gi6rgi/autonomous-drone-v2/hardware/frame_v3/print/box_deck.stl

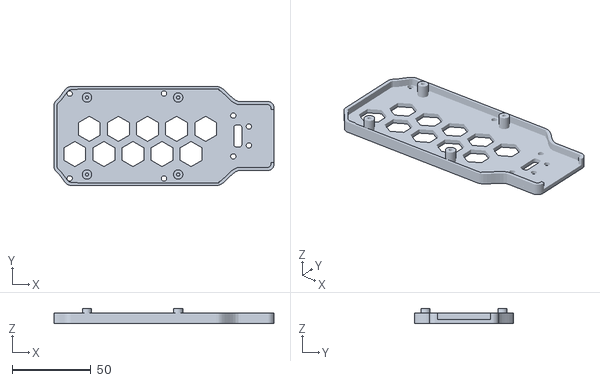
[picture p1: CAD file, 2026-11-09]
hardware/frame_v3/print/box_deck.stl
140.0 x 63.0 x 9.50
