gi6rgi/autonomous-drone-v2/software/sim/gazebo/models/drone_v2/meshes/prop_ccw.stl

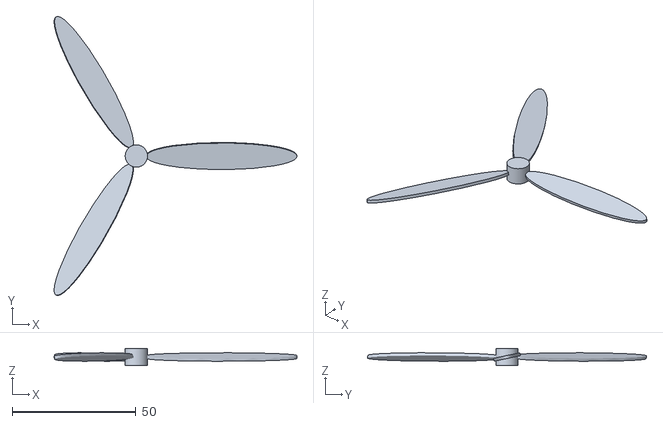
[picture p2: CAD file, 2026-09-15]
software/sim/gazebo/models/drone_v2/meshes/prop_ccw.stl
97.9 x 112.5 x 7.00
