gi6rgi/autonomous-drone-v2/hardware/frame_v3/print/box_cradle.stl

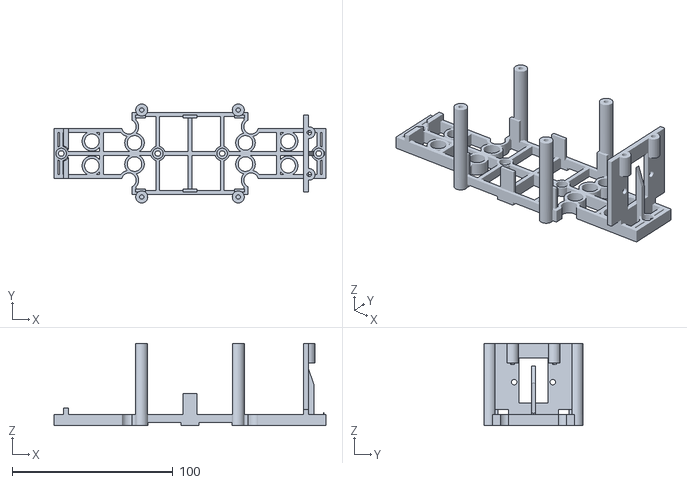
[picture p3: CAD file, 2026-11-09]
hardware/frame_v3/print/box_cradle.stl
169.0 x 61.5 x 51.0
