gi6rgi/autonomous-drone-v2/software/sim/gazebo/models/drone_v2/meshes/frame.stl

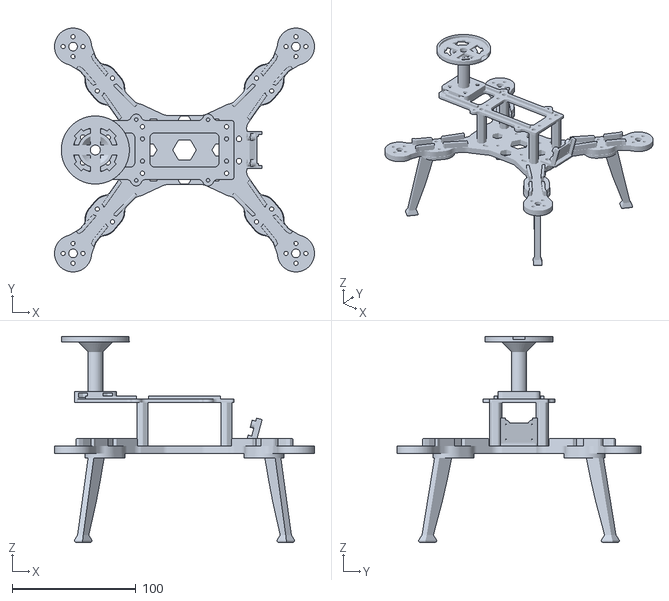
[picture p4: CAD file, 2026-09-15]
software/sim/gazebo/models/drone_v2/meshes/frame.stl
210.0 x 197.0 x 166.5
