gi6rgi/autonomous-drone-v2/hardware/frame_v3/print/coupon_arm_S.stl

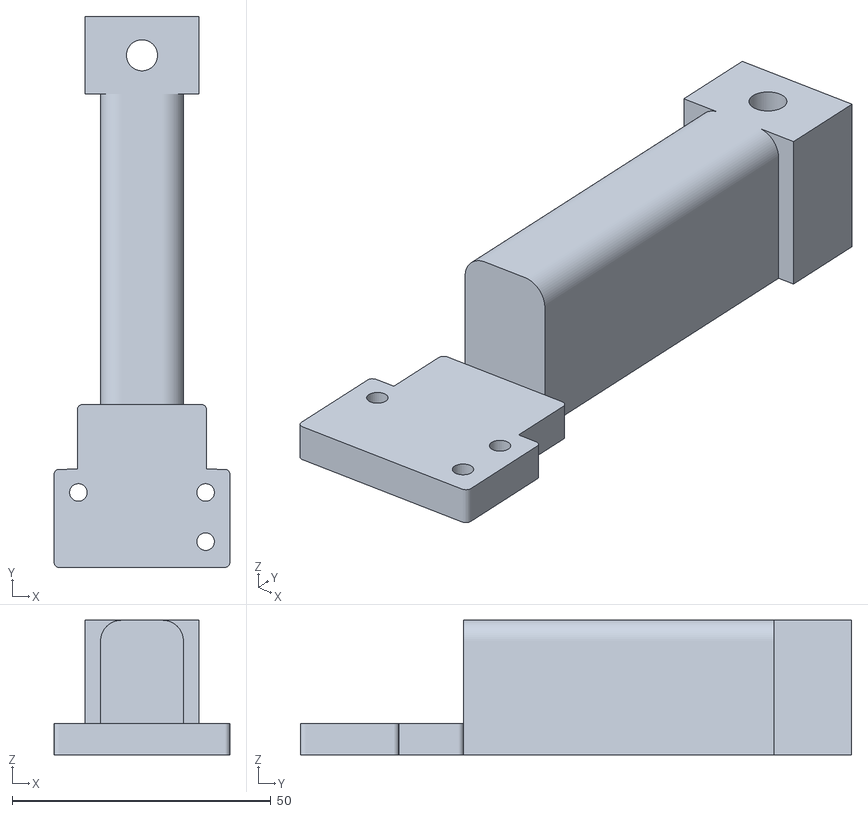
[picture p5: CAD file, 2026-11-09]
hardware/frame_v3/print/coupon_arm_S.stl
34.0 x 106.5 x 26.0
