gi6rgi/autonomous-drone-v2/software/sim/gazebo/models/drone_v2/meshes/electronics.stl

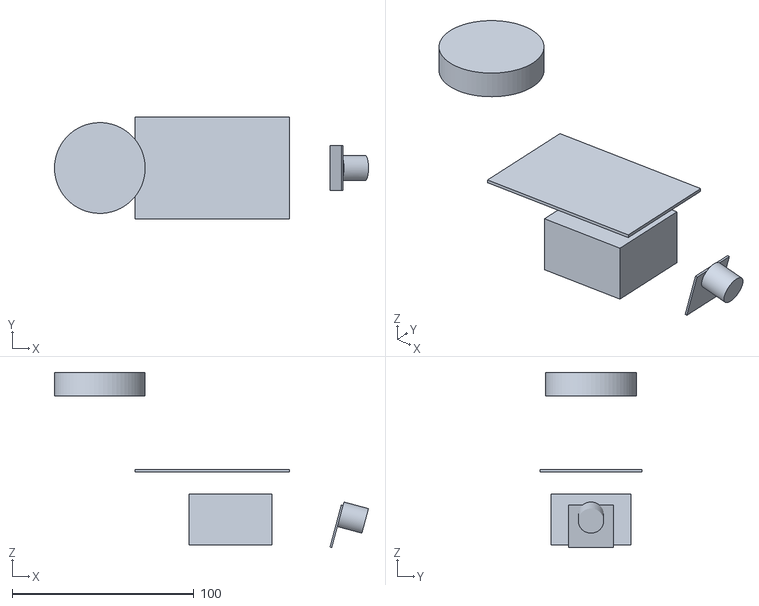
[picture p6: CAD file, 2026-09-15]
software/sim/gazebo/models/drone_v2/meshes/electronics.stl
173.0 x 56.0 x 96.5
