gi6rgi/autonomous-drone-v2/hardware/frame_v3/print/ring_a.stl

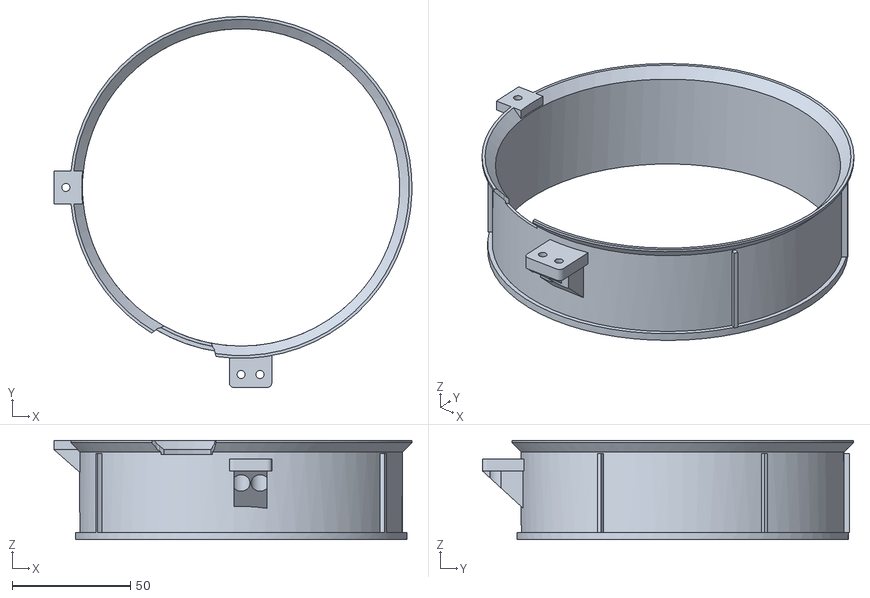
[picture p7: CAD file, 2026-11-09]
hardware/frame_v3/print/ring_a.stl
151.2 x 156.7 x 42.0
