gi6rgi/autonomous-drone-v2/hardware/frame_v3/print/spine_bottom.stl

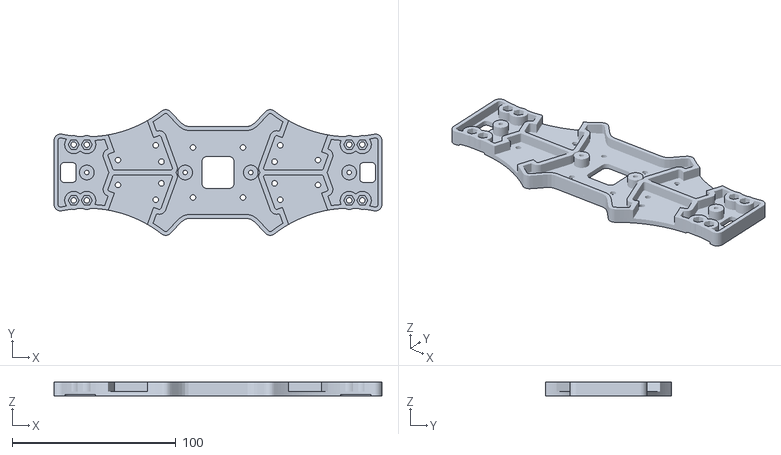
[picture p8: CAD file, 2026-11-09]
hardware/frame_v3/print/spine_bottom.stl
200.0 x 76.7 x 8.80
