gi6rgi/autonomous-drone-v2/software/sim/gazebo/models/drone_v2/meshes/motors.stl

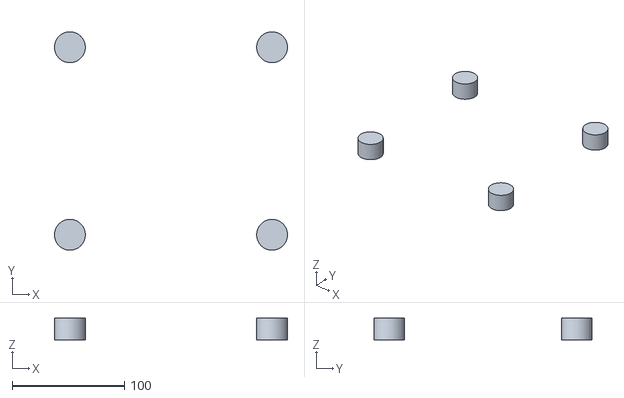
[picture p9: CAD file, 2026-09-15]
software/sim/gazebo/models/drone_v2/meshes/motors.stl
207.5 x 194.5 x 19.2
