gi6rgi/autonomous-drone-v2/hardware/frame_v3/print/arm_a.stl

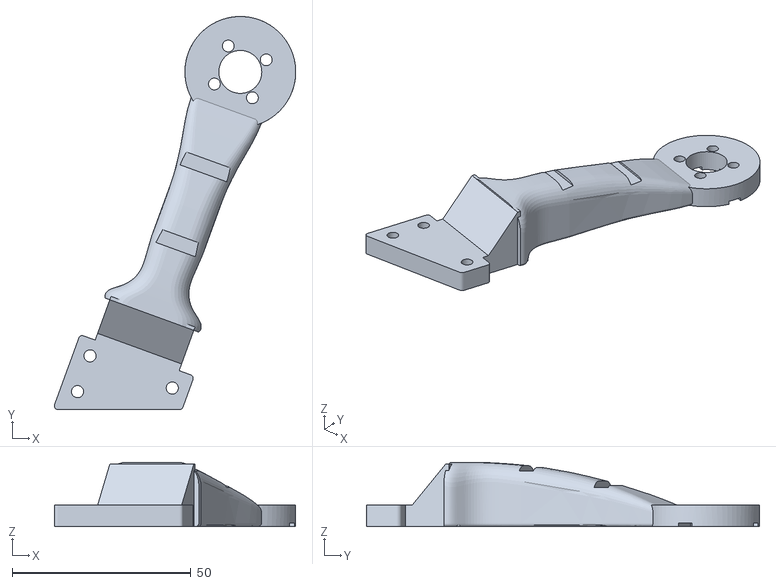
[picture p10: CAD file, 2026-11-09]
hardware/frame_v3/print/arm_a.stl
67.5 x 109.9 x 18.0
