gi6rgi/autonomous-drone-v2/software/sim/gazebo/models/drone_v2/meshes/battery.stl

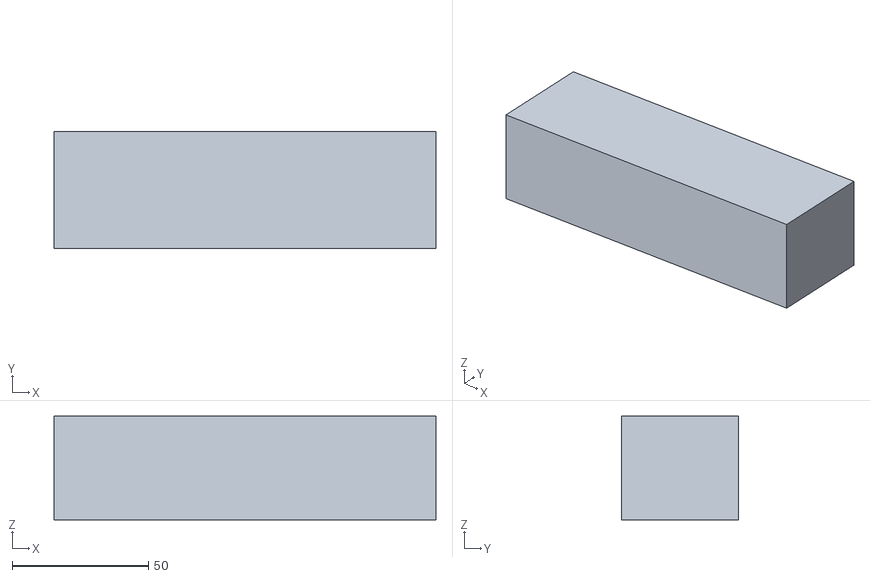
[picture p11: CAD file, 2026-09-15]
software/sim/gazebo/models/drone_v2/meshes/battery.stl
140.0 x 43.0 x 38.0
