gi6rgi/autonomous-drone-v2/hardware/frame_v3/print/coupon_arm_A.stl

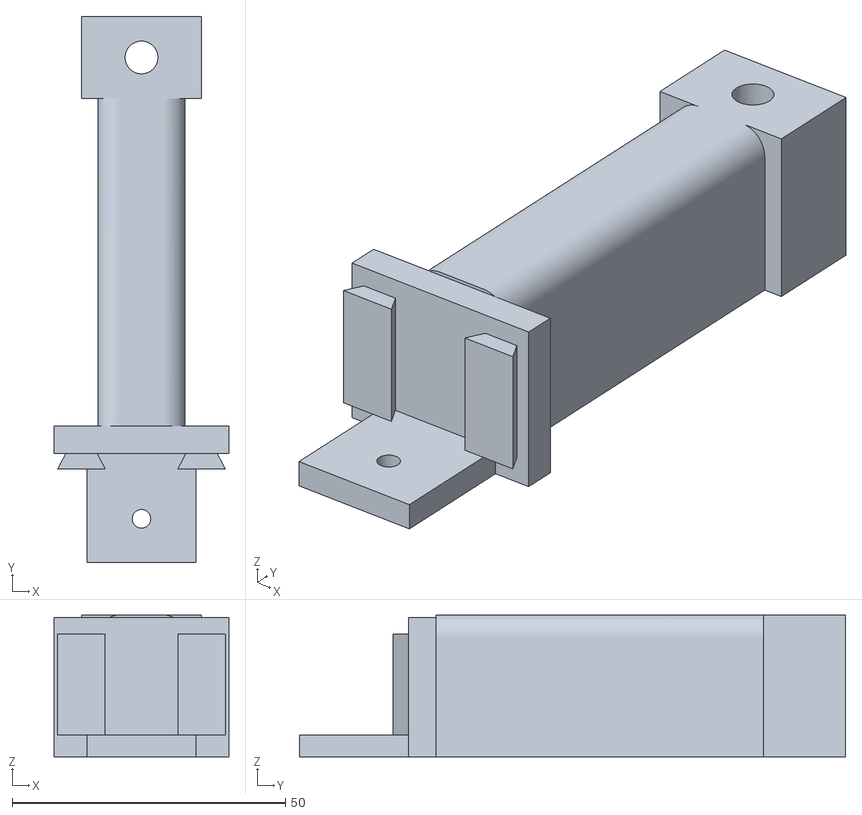
[picture p12: CAD file, 2026-11-09]
hardware/frame_v3/print/coupon_arm_A.stl
32.0 x 100.0 x 26.0
