gi6rgi/autonomous-drone-v2/hardware/frame_v3/print/box_spacer.stl

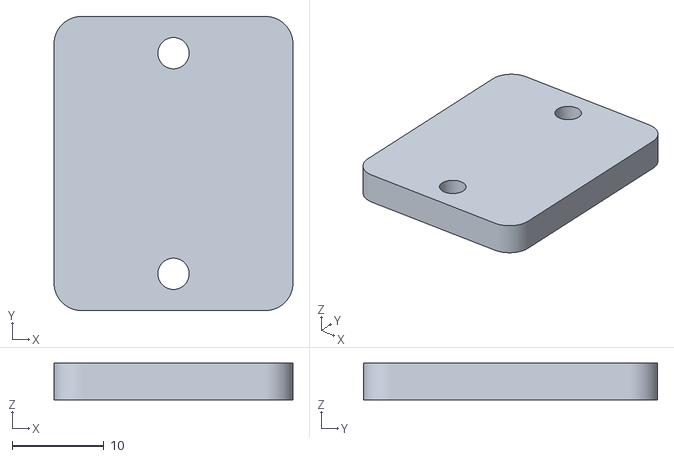
[picture p13: CAD file, 2026-11-09]
hardware/frame_v3/print/box_spacer.stl
26.0 x 32.0 x 4.00
