gi6rgi/autonomous-drone-v2/hardware/frame_v3/print/bridge.stl

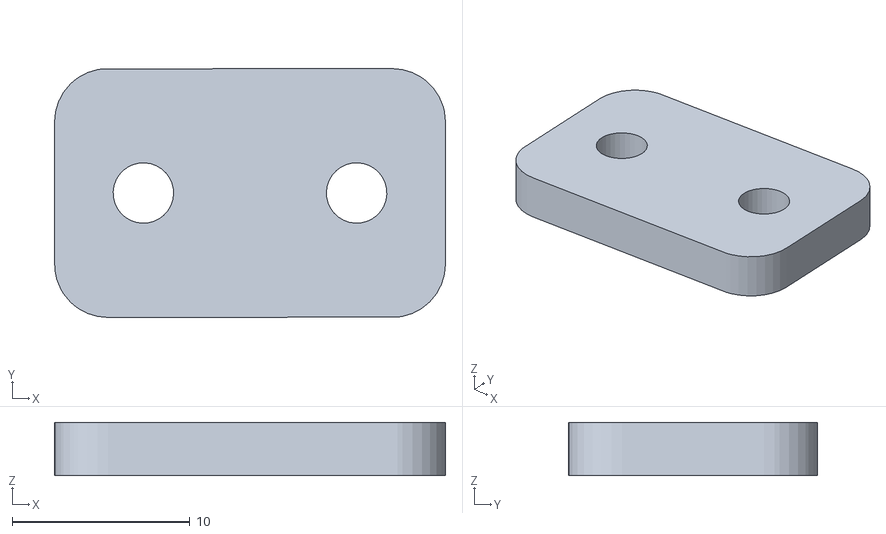
[picture p14: CAD file, 2026-11-09]
hardware/frame_v3/print/bridge.stl
22.0 x 14.0 x 3.00
