gi6rgi/autonomous-drone-v2/hardware/frame_v3/print/skid.stl

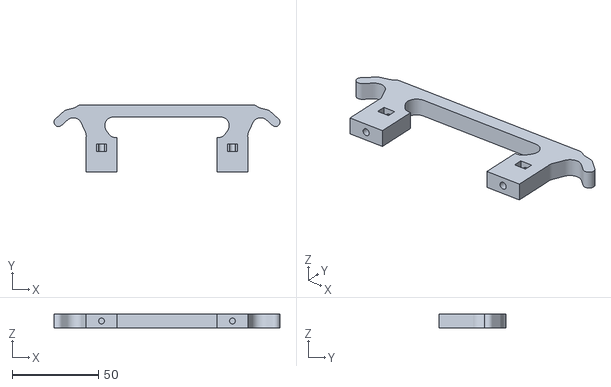
[picture p15: CAD file, 2026-11-09]
hardware/frame_v3/print/skid.stl
131.2 x 39.0 x 8.00
