gi6rgi/autonomous-drone-v2/hardware/frame_v3/print/box_camera.stl

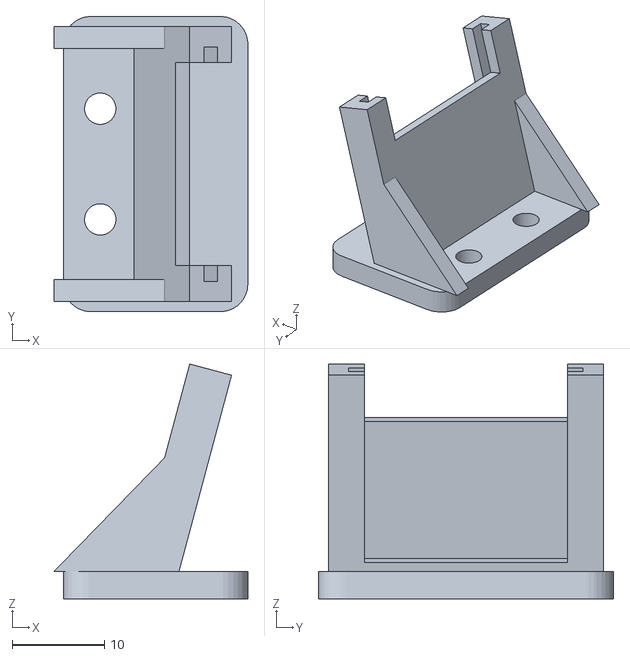
[picture p16: CAD file, 2026-11-09]
hardware/frame_v3/print/box_camera.stl
21.0 x 32.0 x 25.5
