gi6rgi/autonomous-drone-v2/hardware/frame_v3/print/spine_top.stl

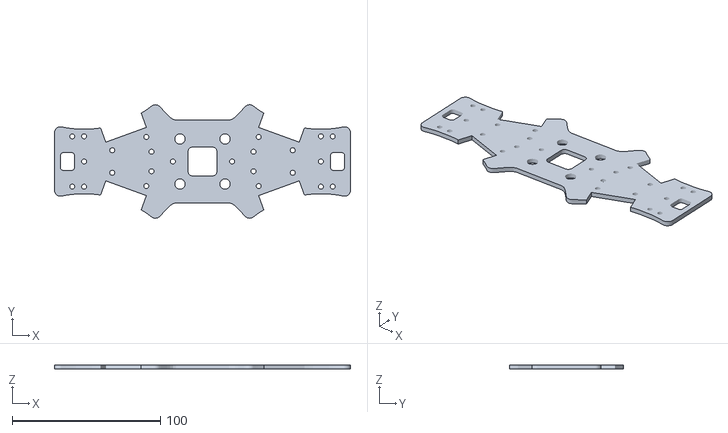
[picture p17: CAD file, 2026-11-09]
hardware/frame_v3/print/spine_top.stl
200.0 x 76.7 x 3.00
