gi6rgi/autonomous-drone-v2/hardware/frame_v3/print/coupon_top_S.stl

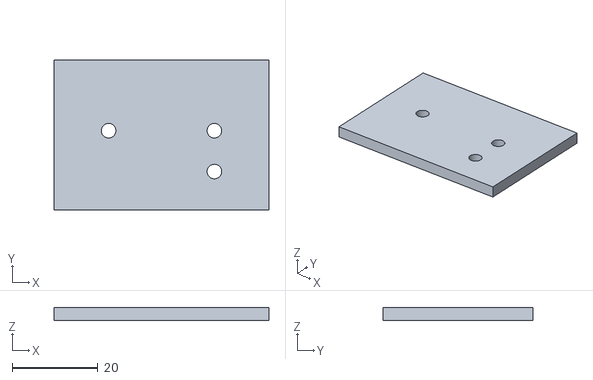
[picture p18: CAD file, 2026-11-09]
hardware/frame_v3/print/coupon_top_S.stl
50.0 x 35.0 x 3.00
