gi6rgi/autonomous-drone-v2/hardware/frame_v3/print/coupon_base.stl

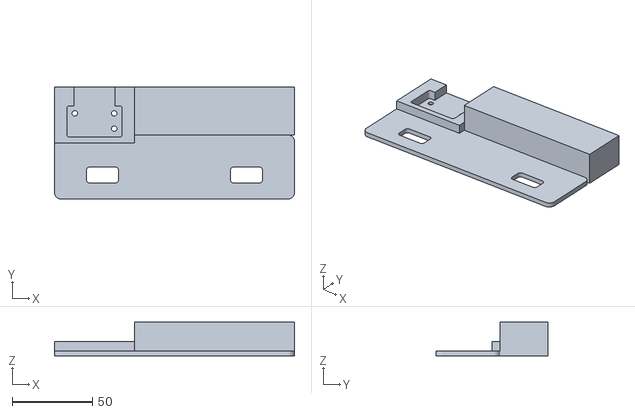
[picture p19: CAD file, 2026-11-09]
hardware/frame_v3/print/coupon_base.stl
150.0 x 70.0 x 21.0
