gi6rgi/autonomous-drone-v2/(list of files, cad)

Other CAD files:
software/sim/gazebo/models/drone_v2/meshes/prop_cw.stl
hardware/frame_v3/print/coupon_arm_B.stl
hardware/frame_v3/print/arm_b.stl
hardware/frame_v3/print/ring_b.stl
hardware/frame/print/camera_mount.stl
hardware/frame/print/deck.stl
hardware/frame/print/gps_mount.stl
hardware/frame/print/leg.stl
hardware/frame/print/plate_v2.stl
hardware/frame/print/standoff_35.stl
hardware/frame/print/test_motor_pad.stl
