gi6rgi/autonomous-drone-v2/software/sim/gazebo/models/drone_v2/model.sdf

<?xml version="1.0"?>
<!-- generated by software/sim/gazebo/gen_model.py from mass_props.json; do not edit by hand -->
<!-- mass 1.1425 kg, max thrust 15.7 N per motor, virtual rotor 1000 rad/s, blade area 0.00498 m² -->
<sdf version="1.9">
  <model name="drone_v2">
    <link name="base_link">
      <inertial>
        <pose>0.00121 -0.0 -0.00176 0 0 0</pose>
        <mass>1.1425</mass>
        <inertia>
          <ixx>0.0025078</ixx><ixy>-0.0</ixy><ixz>0.0003831</ixz>
          <iyy>0.0040969</iyy><iyz>0.0</iyz><izz>0.0045389</izz>
        </inertia>
      </inertial>
      <visual name="frame">
        <pose>0 0 0 0 0 0</pose>
        <geometry><mesh><uri>model://drone_v2/meshes/frame.stl</uri><scale>0.001 0.001 0.001</scale></mesh></geometry>
        <material><ambient>0.55 0.57 0.6 1.0</ambient><diffuse>0.55 0.57 0.6 1.0</diffuse><specular>0.2 0.2 0.2 1</specular></material>
      </visual>
      <visual name="electronics">
        <pose>0 0 0 0 0 0</pose>
        <geometry><mesh><uri>model://drone_v2/meshes/electronics.stl</uri><scale>0.001 0.001 0.001</scale></mesh></geometry>
        <material><ambient>0.1 0.45 0.15 1.0</ambient><diffuse>0.1 0.45 0.15 1.0</diffuse><specular>0.2 0.2 0.2 1</specular></material>
      </visual>
      <visual name="battery">
        <pose>0 0 0 0 0 0</pose>
        <geometry><mesh><uri>model://drone_v2/meshes/battery.stl</uri><scale>0.001 0.001 0.001</scale></mesh></geometry>
        <material><ambient>0.1 0.1 0.4 1.0</ambient><diffuse>0.1 0.1 0.4 1.0</diffuse><specular>0.2 0.2 0.2 1</specular></material>
      </visual>
      <visual name="motors">
        <pose>0 0 0 0 0 0</pose>
        <geometry><mesh><uri>model://drone_v2/meshes/motors.stl</uri><scale>0.001 0.001 0.001</scale></mesh></geometry>
        <material><ambient>0.1 0.1 0.1 1.0</ambient><diffuse>0.1 0.1 0.1 1.0</diffuse><specular>0.2 0.2 0.2 1</specular></material>
      </visual>
      <collision name="battery_collision">
        <pose>0.007 0.0 -0.021 0 0 0</pose>
        <geometry><box><size>0.14 0.043000000000000003 0.038</size></box></geometry>
      </collision>
      <collision name="plate_collision">
        <pose>0.0 0.0 0.003 0 0 0</pose>
        <geometry><box><size>0.10200000000000001 0.056 0.006</size></box></geometry>
      </collision>
      <collision name="foot_0">
        <pose>-0.0818 -0.0738 -0.0681 0 0 0</pose>
        <geometry><sphere><radius>0.004</radius></sphere></geometry>
        <surface>
          <contact><ode><min_depth>0.0005</min_depth><max_vel>100</max_vel></ode></contact>
          <friction><ode><mu>1.0</mu><mu2>1.0</mu2></ode></friction>
        </surface>
      </collision>
      <collision name="foot_1">
        <pose>-0.0818 0.0738 -0.0681 0 0 0</pose>
        <geometry><sphere><radius>0.004</radius></sphere></geometry>
        <surface>
          <contact><ode><min_depth>0.0005</min_depth><max_vel>100</max_vel></ode></contact>
          <friction><ode><mu>1.0</mu><mu2>1.0</mu2></ode></friction>
        </surface>
      </collision>
      <collision name="foot_2">
        <pose>0.0818 -0.0738 -0.0681 0 0 0</pose>
        <geometry><sphere><radius>0.004</radius></sphere></geometry>
        <surface>
          <contact><ode><min_depth>0.0005</min_depth><max_vel>100</max_vel></ode></contact>
          <friction><ode><mu>1.0</mu><mu2>1.0</mu2></ode></friction>
        </surface>
      </collision>
      <collision name="foot_3">
        <pose>0.0818 0.0738 -0.0681 0 0 0</pose>
        <geometry><sphere><radius>0.004</radius></sphere></geometry>
        <surface>
          <contact><ode><min_depth>0.0005</min_depth><max_vel>100</max_vel></ode></contact>
          <friction><ode><mu>1.0</mu><mu2>1.0</mu2></ode></friction>
        </surface>
      </collision>
    </link>

    <link name="imu_link">
      <pose>0.00121 -0.0 -0.00176 0 0 0</pose>
      <inertial><mass>0.001</mass><inertia><ixx>1e-7</ixx><iyy>1e-7</iyy><izz>1e-7</izz><ixy>0</ixy><ixz>0</ixz><iyz>0</iyz></inertia></inertial>
      <sensor name="imu_sensor" type="imu">
        <pose degrees="true">0 0 0 180 0 0</pose>
        <always_on>1</always_on>
        <update_rate>1000</update_rate>
      </sensor>
    </link>
    <joint name="imu_joint" type="fixed">
      <parent>base_link</parent>
      <child>imu_link</child>
    </joint>
    <link name="rotor_0">
      <pose>0.09 -0.0835 0.0282 0 0 0</pose>
      <inertial>
        <mass>0.0101</mass>
        <inertia><ixx>2.5e-05</ixx><iyy>2.5e-05</iyy><izz>5e-05</izz><ixy>0</ixy><ixz>0</ixz><iyz>0</iyz></inertia>
      </inertial>
      <visual name="visual">
        <pose>0 0 0 0 0 0</pose>
        <geometry><mesh><uri>model://drone_v2/meshes/prop_ccw.stl</uri><scale>0.001 0.001 0.001</scale></mesh></geometry>
        <material><ambient>0.15 0.15 0.15 1.0</ambient><diffuse>0.15 0.15 0.15 1.0</diffuse><specular>0.2 0.2 0.2 1</specular></material>
      </visual>
    </link>
    <joint name="rotor_0_joint" type="revolute">
      <parent>base_link</parent>
      <child>rotor_0</child>
      <axis>
        <xyz>0 0 1</xyz>
        <limit><lower>-1e+16</lower><upper>1e+16</upper></limit>
        <dynamics><damping>0.0</damping></dynamics>
      </axis>
    </joint>
    <link name="rotor_1">
      <pose>-0.09 0.0835 0.0282 0 0 0</pose>
      <inertial>
        <mass>0.0101</mass>
        <inertia><ixx>2.5e-05</ixx><iyy>2.5e-05</iyy><izz>5e-05</izz><ixy>0</ixy><ixz>0</ixz><iyz>0</iyz></inertia>
      </inertial>
      <visual name="visual">
        <pose>0 0 0 0 0 0</pose>
        <geometry><mesh><uri>model://drone_v2/meshes/prop_ccw.stl</uri><scale>0.001 0.001 0.001</scale></mesh></geometry>
        <material><ambient>0.15 0.15 0.15 1.0</ambient><diffuse>0.15 0.15 0.15 1.0</diffuse><specular>0.2 0.2 0.2 1</specular></material>
      </visual>
    </link>
    <joint name="rotor_1_joint" type="revolute">
      <parent>base_link</parent>
      <child>rotor_1</child>
      <axis>
        <xyz>0 0 1</xyz>
        <limit><lower>-1e+16</lower><upper>1e+16</upper></limit>
        <dynamics><damping>0.0</damping></dynamics>
      </axis>
    </joint>
    <link name="rotor_2">
      <pose>0.09 0.0835 0.0282 0 0 0</pose>
      <inertial>
        <mass>0.0101</mass>
        <inertia><ixx>2.5e-05</ixx><iyy>2.5e-05</iyy><izz>5e-05</izz><ixy>0</ixy><ixz>0</ixz><iyz>0</iyz></inertia>
      </inertial>
      <visual name="visual">
        <pose>0 0 0 0 0 0</pose>
        <geometry><mesh><uri>model://drone_v2/meshes/prop_cw.stl</uri><scale>0.001 0.001 0.001</scale></mesh></geometry>
        <material><ambient>0.1 0.35 0.7 1.0</ambient><diffuse>0.1 0.35 0.7 1.0</diffuse><specular>0.2 0.2 0.2 1</specular></material>
      </visual>
    </link>
    <joint name="rotor_2_joint" type="revolute">
      <parent>base_link</parent>
      <child>rotor_2</child>
      <axis>
        <xyz>0 0 1</xyz>
        <limit><lower>-1e+16</lower><upper>1e+16</upper></limit>
        <dynamics><damping>0.0</damping></dynamics>
      </axis>
    </joint>
    <link name="rotor_3">
      <pose>-0.09 -0.0835 0.0282 0 0 0</pose>
      <inertial>
        <mass>0.0101</mass>
        <inertia><ixx>2.5e-05</ixx><iyy>2.5e-05</iyy><izz>5e-05</izz><ixy>0</ixy><ixz>0</ixz><iyz>0</iyz></inertia>
      </inertial>
      <visual name="visual">
        <pose>0 0 0 0 0 0</pose>
        <geometry><mesh><uri>model://drone_v2/meshes/prop_cw.stl</uri><scale>0.001 0.001 0.001</scale></mesh></geometry>
        <material><ambient>0.1 0.35 0.7 1.0</ambient><diffuse>0.1 0.35 0.7 1.0</diffuse><specular>0.2 0.2 0.2 1</specular></material>
      </visual>
    </link>
    <joint name="rotor_3_joint" type="revolute">
      <parent>base_link</parent>
      <child>rotor_3</child>
      <axis>
        <xyz>0 0 1</xyz>
        <limit><lower>-1e+16</lower><upper>1e+16</upper></limit>
        <dynamics><damping>0.0</damping></dynamics>
      </axis>
    </joint>
    <link name="camera_link">
      <pose degrees="true">0.0737 0.0 0.0233 0 15.0 0</pose>
      <inertial><mass>0.001</mass><inertia><ixx>1e-7</ixx><iyy>1e-7</iyy><izz>1e-7</izz><ixy>0</ixy><ixz>0</ixz><iyz>0</iyz></inertia></inertial>
      <sensor name="camera" type="wideanglecamera">
        <always_on>1</always_on>
        <update_rate>30</update_rate>
        <topic>drone_v2/camera</topic>
        <camera>
          <horizontal_fov>2.7053</horizontal_fov>
          <image><width>640</width><height>480</height><format>R8G8B8</format></image>
          <clip><near>0.02</near><far>200</far></clip>
          <lens>
            <type>equidistant</type>
            <scale_to_hfov>true</scale_to_hfov>
            <cutoff_angle>1.5533</cutoff_angle>
            <env_texture_size>1024</env_texture_size>
          </lens>
        </camera>
      </sensor>
    </link>
    <joint name="camera_joint" type="fixed">
      <parent>base_link</parent>
      <child>camera_link</child>
    </joint>

    <plugin filename="gz-sim-joint-state-publisher-system" name="gz::sim::systems::JointStatePublisher"/>
    <plugin filename="gz-sim-lift-drag-system" name="gz::sim::systems::LiftDrag">
      <a0>0.3</a0><alpha_stall>1.4</alpha_stall>
      <cla>4.25</cla><cda>0.1</cda><cma>0.0</cma>
      <cla_stall>-0.025</cla_stall><cda_stall>0.0</cda_stall><cma_stall>0.0</cma_stall>
      <area>0.004977</area><air_density>1.2041</air_density>
      <cp>0.0453 0 0</cp><forward>0 1 0</forward><upward>0 0 1</upward>
      <link_name>rotor_0</link_name>
    </plugin>
    <plugin filename="gz-sim-lift-drag-system" name="gz::sim::systems::LiftDrag">
      <a0>0.3</a0><alpha_stall>1.4</alpha_stall>
      <cla>4.25</cla><cda>0.1</cda><cma>0.0</cma>
      <cla_stall>-0.025</cla_stall><cda_stall>0.0</cda_stall><cma_stall>0.0</cma_stall>
      <area>0.004977</area><air_density>1.2041</air_density>
      <cp>-0.0453 0 0</cp><forward>0 -1 0</forward><upward>0 0 1</upward>
      <link_name>rotor_0</link_name>
    </plugin>
    <plugin filename="gz-sim-lift-drag-system" name="gz::sim::systems::LiftDrag">
      <a0>0.3</a0><alpha_stall>1.4</alpha_stall>
      <cla>4.25</cla><cda>0.1</cda><cma>0.0</cma>
      <cla_stall>-0.025</cla_stall><cda_stall>0.0</cda_stall><cma_stall>0.0</cma_stall>
      <area>0.004977</area><air_density>1.2041</air_density>
      <cp>0.0453 0 0</cp><forward>0 1 0</forward><upward>0 0 1</upward>
      <link_name>rotor_1</link_name>
    </plugin>
    <plugin filename="gz-sim-lift-drag-system" name="gz::sim::systems::LiftDrag">
      <a0>0.3</a0><alpha_stall>1.4</alpha_stall>
      <cla>4.25</cla><cda>0.1</cda><cma>0.0</cma>
      <cla_stall>-0.025</cla_stall><cda_stall>0.0</cda_stall><cma_stall>0.0</cma_stall>
      <area>0.004977</area><air_density>1.2041</air_density>
      <cp>-0.0453 0 0</cp><forward>0 -1 0</forward><upward>0 0 1</upward>
      <link_name>rotor_1</link_name>
    </plugin>
    <plugin filename="gz-sim-lift-drag-system" name="gz::sim::systems::LiftDrag">
      <a0>0.3</a0><alpha_stall>1.4</alpha_stall>
      <cla>4.25</cla><cda>0.1</cda><cma>0.0</cma>
      <cla_stall>-0.025</cla_stall><cda_stall>0.0</cda_stall><cma_stall>0.0</cma_stall>
      <area>0.004977</area><air_density>1.2041</air_density>
      <cp>0.0453 0 0</cp><forward>0 -1 0</forward><upward>0 0 1</upward>
      <link_name>rotor_2</link_name>
    </plugin>
    <plugin filename="gz-sim-lift-drag-system" name="gz::sim::systems::LiftDrag">
      <a0>0.3</a0><alpha_stall>1.4</alpha_stall>
      <cla>4.25</cla><cda>0.1</cda><cma>0.0</cma>
      <cla_stall>-0.025</cla_stall><cda_stall>0.0</cda_stall><cma_stall>0.0</cma_stall>
      <area>0.004977</area><air_density>1.2041</air_density>
      <cp>-0.0453 0 0</cp><forward>0 1 0</forward><upward>0 0 1</upward>
      <link_name>rotor_2</link_name>
    </plugin>
    <plugin filename="gz-sim-lift-drag-system" name="gz::sim::systems::LiftDrag">
      <a0>0.3</a0><alpha_stall>1.4</alpha_stall>
      <cla>4.25</cla><cda>0.1</cda><cma>0.0</cma>
      <cla_stall>-0.025</cla_stall><cda_stall>0.0</cda_stall><cma_stall>0.0</cma_stall>
      <area>0.004977</area><air_density>1.2041</air_density>
      <cp>0.0453 0 0</cp><forward>0 -1 0</forward><upward>0 0 1</upward>
      <link_name>rotor_3</link_name>
    </plugin>
    <plugin filename="gz-sim-lift-drag-system" name="gz::sim::systems::LiftDrag">
      <a0>0.3</a0><alpha_stall>1.4</alpha_stall>
      <cla>4.25</cla><cda>0.1</cda><cma>0.0</cma>
      <cla_stall>-0.025</cla_stall><cda_stall>0.0</cda_stall><cma_stall>0.0</cma_stall>
      <area>0.004977</area><air_density>1.2041</air_density>
      <cp>-0.0453 0 0</cp><forward>0 1 0</forward><upward>0 0 1</upward>
      <link_name>rotor_3</link_name>
    </plugin>
    <plugin filename="gz-sim-apply-joint-force-system" name="gz::sim::systems::ApplyJointForce">
      <joint_name>rotor_0_joint</joint_name>
    </plugin>
    <plugin filename="gz-sim-apply-joint-force-system" name="gz::sim::systems::ApplyJointForce">
      <joint_name>rotor_1_joint</joint_name>
    </plugin>
    <plugin filename="gz-sim-apply-joint-force-system" name="gz::sim::systems::ApplyJointForce">
      <joint_name>rotor_2_joint</joint_name>
    </plugin>
    <plugin filename="gz-sim-apply-joint-force-system" name="gz::sim::systems::ApplyJointForce">
      <joint_name>rotor_3_joint</joint_name>
    </plugin>

    <plugin name="ArduPilotPlugin" filename="ArduPilotPlugin">
      <fdm_addr>127.0.0.1</fdm_addr>
      <fdm_port_in>9002</fdm_port_in>
      <connectionTimeoutMaxCount>5</connectionTimeoutMaxCount>
      <lock_step>1</lock_step>
      <no_time_sync>1</no_time_sync>
      <have_32_channels>0</have_32_channels>
      <modelXYZToAirplaneXForwardZDown degrees="true">0 0 0 180 0 0</modelXYZToAirplaneXForwardZDown>
      <gazeboXYZToNED degrees="true">0 0 0 180 0 90</gazeboXYZToNED>
      <imuName>imu_link::imu_sensor</imuName>
      <control channel="0">
        <jointName>rotor_0_joint</jointName>
        <useForce>1</useForce>
        <multiplier>1000</multiplier>
        <offset>0</offset>
        <servo_min>1100</servo_min>
        <servo_max>1900</servo_max>
        <type>VELOCITY</type>
        <p_gain>0.02</p_gain><i_gain>0</i_gain><d_gain>0</d_gain>
        <i_max>0</i_max><i_min>0</i_min>
        <cmd_max>1.0</cmd_max><cmd_min>-1.0</cmd_min>
        <controlVelocitySlowdownSim>1</controlVelocitySlowdownSim>
      </control>
      <control channel="1">
        <jointName>rotor_1_joint</jointName>
        <useForce>1</useForce>
        <multiplier>1000</multiplier>
        <offset>0</offset>
        <servo_min>1100</servo_min>
        <servo_max>1900</servo_max>
        <type>VELOCITY</type>
        <p_gain>0.02</p_gain><i_gain>0</i_gain><d_gain>0</d_gain>
        <i_max>0</i_max><i_min>0</i_min>
        <cmd_max>1.0</cmd_max><cmd_min>-1.0</cmd_min>
        <controlVelocitySlowdownSim>1</controlVelocitySlowdownSim>
      </control>
      <control channel="2">
        <jointName>rotor_2_joint</jointName>
        <useForce>1</useForce>
        <multiplier>-1000</multiplier>
        <offset>0</offset>
        <servo_min>1100</servo_min>
        <servo_max>1900</servo_max>
        <type>VELOCITY</type>
        <p_gain>0.02</p_gain><i_gain>0</i_gain><d_gain>0</d_gain>
        <i_max>0</i_max><i_min>0</i_min>
        <cmd_max>1.0</cmd_max><cmd_min>-1.0</cmd_min>
        <controlVelocitySlowdownSim>1</controlVelocitySlowdownSim>
      </control>
      <control channel="3">
        <jointName>rotor_3_joint</jointName>
        <useForce>1</useForce>
        <multiplier>-1000</multiplier>
        <offset>0</offset>
        <servo_min>1100</servo_min>
        <servo_max>1900</servo_max>
        <type>VELOCITY</type>
        <p_gain>0.02</p_gain><i_gain>0</i_gain><d_gain>0</d_gain>
        <i_max>0</i_max><i_min>0</i_min>
        <cmd_max>1.0</cmd_max><cmd_min>-1.0</cmd_min>
        <controlVelocitySlowdownSim>1</controlVelocitySlowdownSim>
      </control>
    </plugin>
  </model>
</sdf>
