gi6rgi/autonomous-drone-v2/(commit log)

2026-09-04 print: v2 stl components
    [camera_mount.stl, deck.stl, gps_mount.stl, leg.stl, plate_v2.stl, standoff_35.stl]
2026-09-04 print: more elegant frame and legs
    [leg.stl, plate_v2.stl]
2026-09-04 print: add test motor pad | better motor mounts
    [plate_v2.stl, test_motor_pad.stl]
2026-09-05 print: no support for legs | plate mount updates
    [leg.stl, pin_cam_m4.stl, pin_leg_m3.stl, plate_v2.stl, test_motor_pad.stl]
2026-09-08 print: camera mount update | deck improved
    [camera_mount.stl, deck.stl]
2026-09-08 print: camera mount update
    [camera_mount.stl, standoff_35.stl]
2026-09-12 print: add all stl generation scripts
    [camera_mount.stl, gps_mount.stl, pin_cam_m4.stl, pin_leg_m3.stl, standoff_35.stl]
2026-09-15 simulation: add drone stl model
2026-11-09 frame v3: inverted motors, ducted rings, sandwich arms, top box
    Parametric CadQuery model in hardware/frame_v3: spine sandwich with
    hammer-head arm tongues (cavity walls 0.2 under the tongue so the top
    plate clamps the arm), rings hung under the spine, PETG skids, and a
    box on top with a slide-out battery cradle, Pi 5 deck and camera
    cassette. Print-ready STLs in print/, joint test coupon included.
